free-pdk/f-eval-boards/photos/f-eval-pdk-s08 PFC232.jpeg

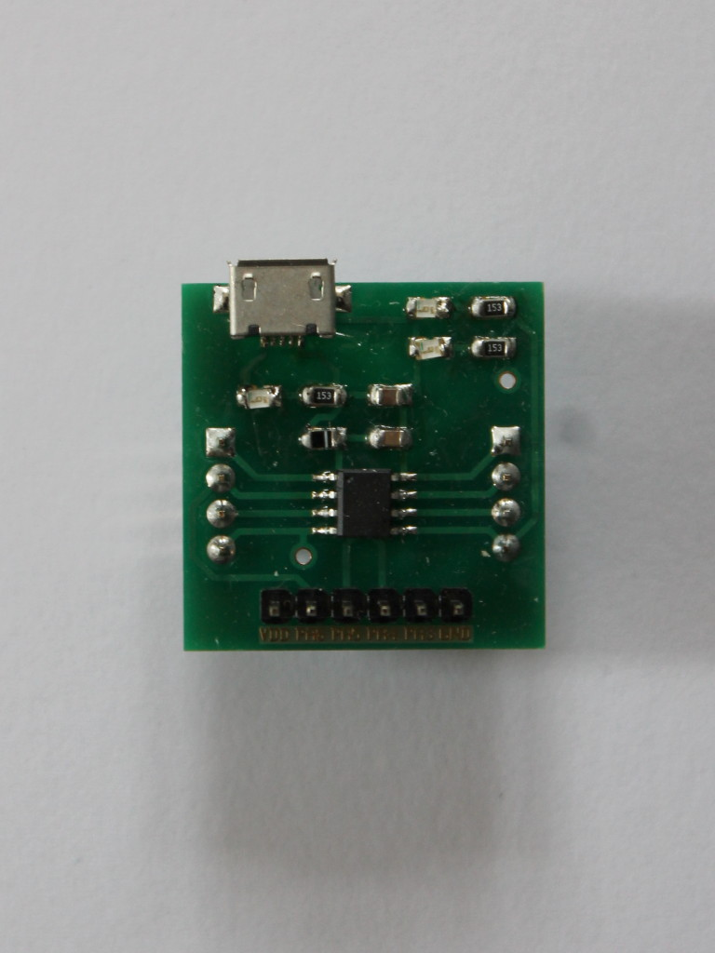
photos/f-eval-pdk-s08 PFC232.jpeg
