free-pdk/f-eval-boards/drawings/README

These schematic drawings have been generated from the source files in the respective board directories.
