free-pdk/f-eval-boards/drawings/pdk-s08.png

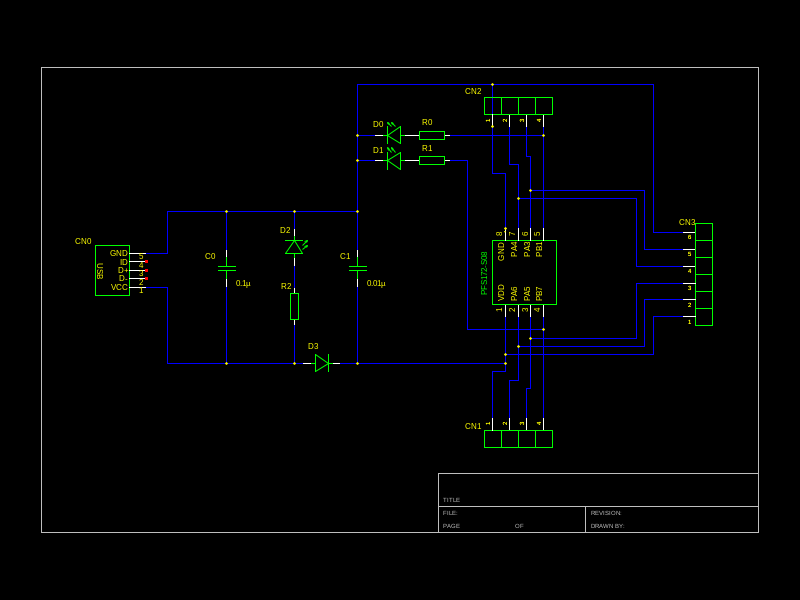
drawings/pdk-s08.png
