free-pdk/f-eval-boards/drawings/pdk-s16.png

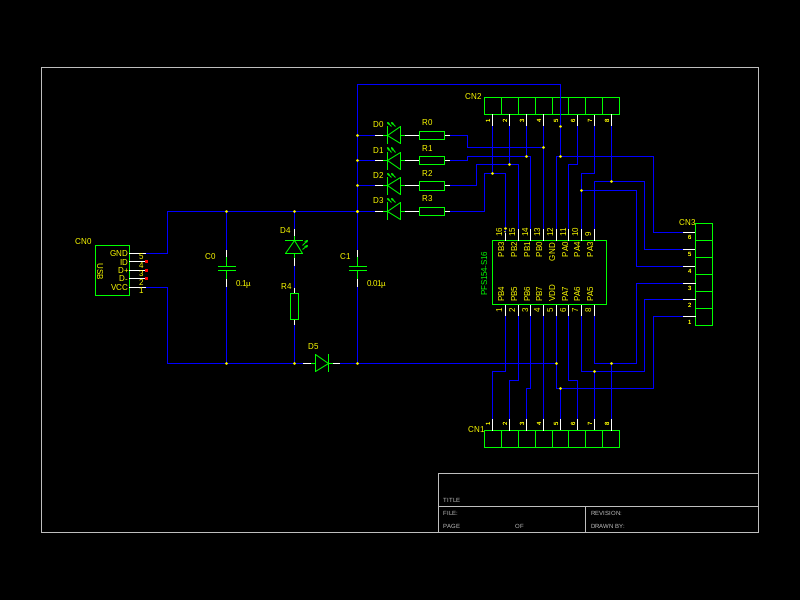
drawings/pdk-s16.png
