free-pdk/f-eval-boards/photos/f-eval-pdk-s08 PFS172.jpeg

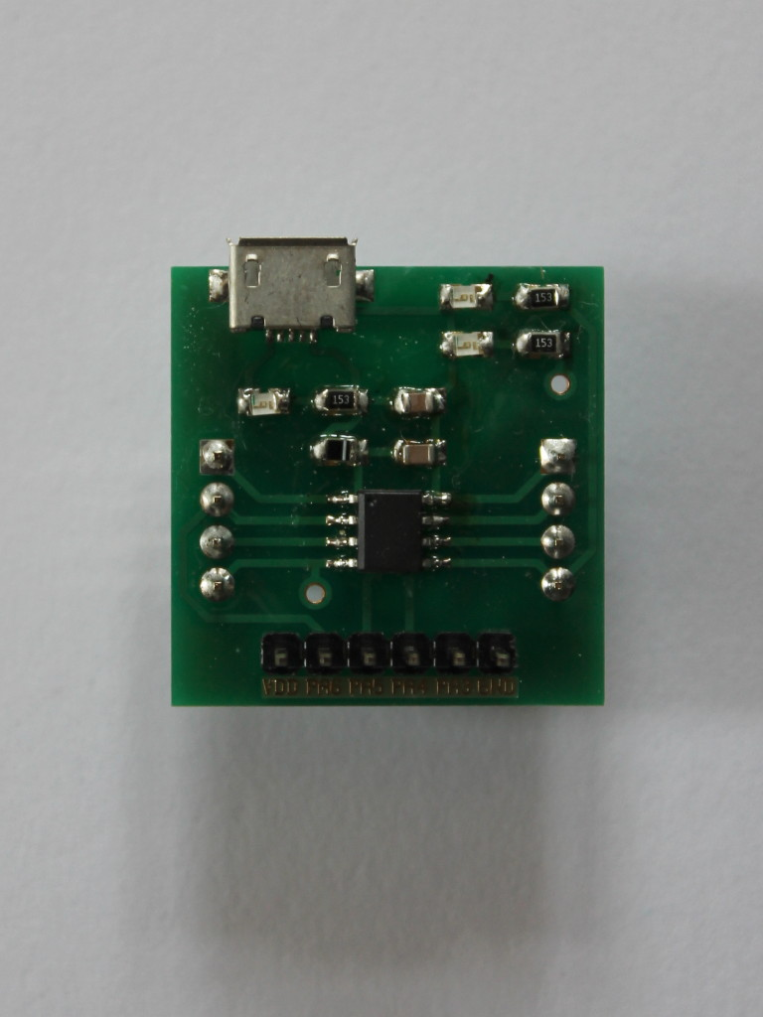
photos/f-eval-pdk-s08 PFS172.jpeg
