free-pdk/f-eval-boards/photos/f-eval-pdk-s16 PFS173.jpeg

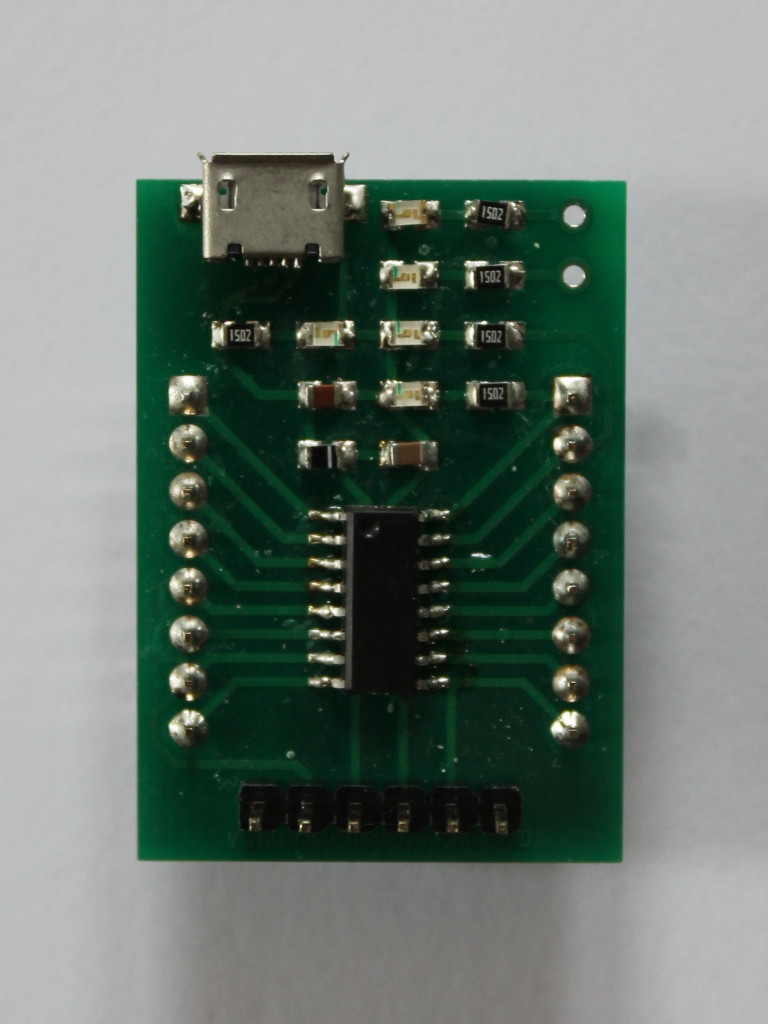
photos/f-eval-pdk-s16 PFS173.jpeg
