free-pdk/f-eval-boards/photos/f-eval-pdk-s16a PFC232.jpeg

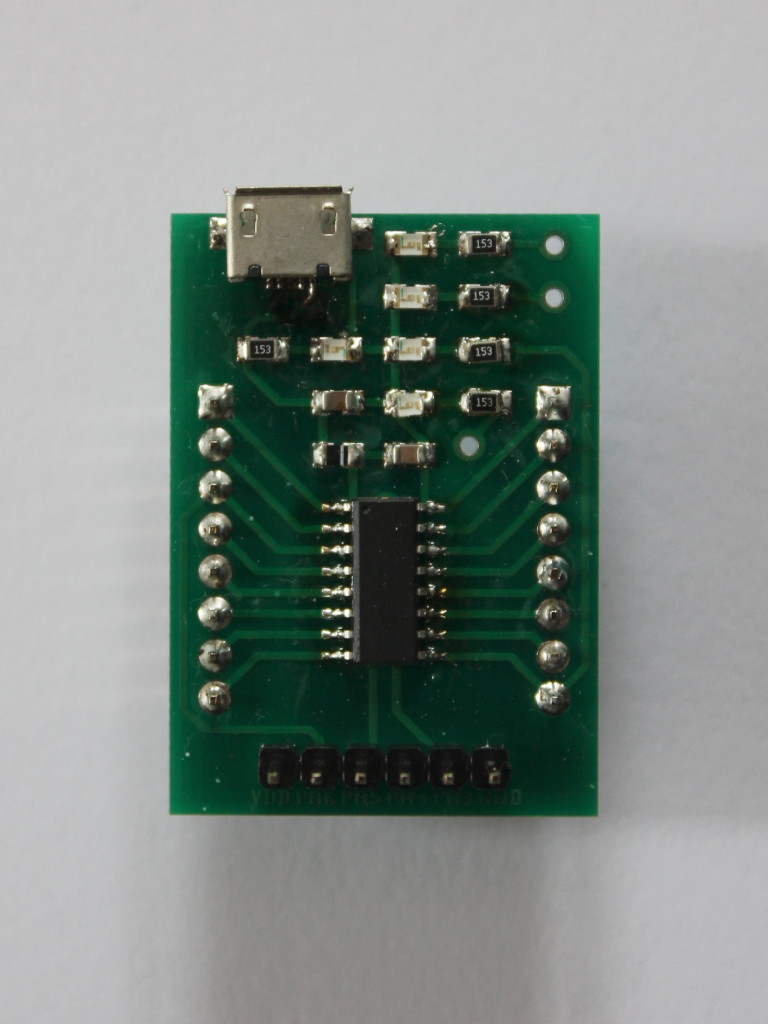
photos/f-eval-pdk-s16a PFC232.jpeg
