free-pdk/f-eval-boards/(threads)

Thread 1 (2020-05-24):

A board for 14-pin SOIC devices

spth, 2020-05-24:
Many Padauk µC are available in 14-pin SOIC packages. It would make sense to have a matching board.

spth, 2020-05-24:
We first need symbols for them: https://github.com/free-pdk/pdk-gschem-symbols/issues/2

spth, 2020-05-25:
Apparently, similar to the S16 situation, there are at least two incompatible pin layouts for the S14:

VCC/GND in the middle: PFS173, PFS154, PFC154.
VCC/GND at the top: PFS172, PFC232.

I guess it would make sense to have both an f-eval-pdk-s14 (middle) and an s-eval-pdk-s14a (top) board.

Thread 2 (2020-06-11):

Migrate to lepton?

spth, 2020-06-11:
The schematics were crated using gEDA gschem. But it seems the lepton fork now has more momentum (e.g. the gEDA Debian maintainer switched to lepton). It might make sense to migrate to lepton for the schematics (like pcb-rnd is already used instead of gEDA pcb for the pcb layout).

This is not urgent, as the current schematics were done using pre-fork gschem, so they can be opened in both current gEDA gschem and lepton.

Thread 4 (2020-06-13):

Silkscreen for pins

spth, 2020-06-13:
For the programming header, having the description on the copper layer is fine.

But for the other pins, it would be good to have their names in silkscreen.

This should be easy for the s08(a,b) boards, but the s16(a) boards will need a bit of redesign, since there is a resistor in the space needed for the name of the upper right pin.

Thread 5 (2022-03-25):

gerbers

kimstik, 2022-03-25:
May gerbers be released?

spth, 2022-03-25:
They should be easy to generate from the .lht files using pcb-rnd.

kimstik, 2022-03-25:
it is! ;) moreover, it is easy to make it from scratch in our favorite editor.

I guess that entry step can be a bit smoother for newbies.

spth, 2022-03-25:
On the other hand, there is a reason pcb-rnd has export targets for popular pcb maker, which result in slightly different gerbers. So by providing gerbers here, there would be an increased risk of the newbie using gerbers unsuitable for their pcb maker.

kimstik, 2022-03-25:
I see your point. No need to impose anything on anyone. let's not confuse them either.
I think we should explicitly state that the PCB design file is "*.lht" and it should be opened in [geda/pcb-rnd](https://repo.hu/projects/pcb-rnd) of version xxx.

Another way is to generate gerbers in all suitable/useful profiles (actually 5) of pcb-rnd.

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

personally, it seems to me that the project is incomplete if I do not see some artifacts releases (binaries/gerbers/etc)

spth, 2022-03-25:
I've now put a note in the README, so those that just want to make a few boards are pointed to pcb-rnd and its export.

Thread 6 (2024-03-11):

A board for 24-pin SOIC devices

spth, 2024-03-11:
The PFC460 and PGS134 are available in a SOP24 (300 mil) package. It would be nice to have a board supporting these powerful devices.

spth, 2024-03-11:
We'll need symbols for them:
https://github.com/free-pdk/pdk-gschem-symbols/issues/5
