free-pdk/f-eval-boards/(commit log)

2019-01-16 Document current scope
2019-01-16 Import schematics and pcb layout
    [pfs154.sch, pfs232.sch]
2019-01-16 Schematic symbols and pcb footprints
2019-06-10 Add Copyright note on boards
2019-08-29 Update device support
2019-09-01 Preparations for pfc151-s08 board
2019-09-01 PFC151-S08 board schematic
    [pfc151.sch]
2019-09-01 PFC151 board layout
2019-09-01 Improve readability of pinnames by removing solder mask
2020-04-24 Rename some boards
    [pfc151.sch, pfs232.sch]
2020-04-27 Rename boards to closely match Padauk device names.
    [pfc151.sch, pfc232.sch, pfs154.sch]
2020-04-27 Remove leftover reference to non-existing PFS232 device (apparently replaced by PFC232 before release).
2020-04-27 Link to sample code for the boards.
2020-05-23 Update device support table
2020-05-23 Rename 8-pin-SOIC-board to allow for addition of future variants.
    [pdk-s08a.sch]
2020-05-23 More board variantes for 8-pin SOIC packages.
    [pdk-s08.sch, pdk-s08b.sch]
2020-05-23 Rename boards for 16-pin SOIC parts.
    [pdk-s16.sch, pdk-s16a.sch]
2020-05-23 Board layout for S16A parts.
2020-05-23 PCB layouts for more 8-pin SOIC-devices.
2020-06-11 Photos of some assembled boards.
2020-06-11 Schematics for those that don't want to use gschem.
2020-10-02 Fix Micro-USB-B footprint.
2022-03-25 Put a not in README for those that just want to make physical boards.
